LouXuezhi/FPGA_farseer_Code/report/llm_log/02_mipi_lane1_fault_location.md

# 02 MIPI lane1 无数据：从寄存器假设到定位单根断线

中文 | [English](02_mipi_lane1_fault_location_en.md)

会话：OV9281 → FZ3B 的 CSI-2 2-lane 接收，lane1 始终收不到完整一行　日期：2026-10-29～30

## 提示词（整理）
> 把整个相机链路跑起来，再尽量提高采集速率。
> （中途补充）OV9281 手册里 lane 数在 0x3039[7:5]，0x3018 不是 lane 数控制；dl1_stop 能变、hsact=0 还分不清 P/N 反接、信号完整性和 PHY 时序，别过早锁定硬件原因。
> （之后）转接板通断我们测了都没问题，也重新共地了，你再测一下。

## 模型回答（摘要）
- 自写 D-PHY + CSI-2 解析 + VDMA 比特流上板：lane0 头字节 `2B 06`（RAW10、WC=1600 高字节），线序和极性正确；lane1 每次都报 SoT 错误。
- 改写 component 模式 D-PHY（IBUFDS_DPHY + IDELAY + ISERDES），每条 lane 同时搜正反两种极性的同步码并扫 tap。lane0 在 tap 0～288 全部 100% 命中；lane1 最高 69%，ECC 几乎全错。
- lane1 命中率随速率下降反而变差（800 Mb/s 59%，256 Mb/s 3%），与普通时序余量问题的规律相反。
- 编一个专用探测比特流：6 根 MIPI 线改成 1.2 V 普通输入加内部下拉，统计高电平占比。只有 D1_N（J8-8）在待机、开流、复位三种状态下都是 0%，其余 5 根随相机状态变化。
- 给出万用表二极管档对比测法：同一对的 P 线（第 7 脚）当参照，分"只插排线"和"只插相机"两种接法测。

## 纠错
- 模型先按 mainline 驱动寄存器表，用 0x3018=0xD0 测"单 lane"，据此认为模组只能 2-lane。用户指出 lane 数在 0x3039[7:5]。模型确认之前的测试并没有切到单 lane，改写 0x3039=0x12 重测（读回生效，但 lane0 字节结构仍是 2-lane 拆分，结论记为"未定"）。
- 早期判断偏向"P/N 反接"，用户提醒保留多种假设。模型改用极性自搜索 PHY 和引脚探测去区分，而不是直接下结论。
- 用户第一次回报"测试 B 第 8 脚 OL"，第二次又说"16 根是 0"。模型没有直接采信，先追问读数是 0.000 还是 OL，并要求测第 2、15 根 GND 确认金手指编号方向没数反。用户复测后改口为"16 和 18 都约 0.5 V"。
- 换新 25P 排线后结果完全不变，模型据此排除排线，把范围缩到相机侧。

## 结果
- 三组测量合并：尾线拔下时金手指 16、18 对 GND 都约 0.5 V；插上后 FPC2-8 对 GND 为 OL；FPC2-8 ↔ FPC1-16 焊盘导通。
- 结论：断点在转接板 FPC1 座第 16 脚与金手指之间（座子引脚虚焊或触点未压实）。之前的通断测试点在焊盘上，没有经过座子引脚，所以没测出来。
- 修复前系统按 lane0 单独出图继续推进（见 03）。
