LouXuezhi/FPGA_farseer_Code/report/llm_log/03_framerate_sweep_false_positive.md

# 03 帧率扫描的假阳性：行数完整不等于画面有效

中文 | [English](03_framerate_sweep_false_positive_en.md)

会话：lane0 单独出图后提高采集帧率　日期：2026-10-30

## 提示词（整理）
> 把相机链路跑起来，然后尽量提高采集速率，看能不能把它完整利用起来。我回来验收。

## 模型回答（摘要）
- lane1 故障期间，先加 lane0-only 解析模式：lane0 带每行的偶数字节，按 RAW8 得到 640×800 半分辨率图像，把 VDMA → DDR 通路先跑通。
- 首帧：144.8 fps，每帧正好 800 行，坏包头 0。
- 写 `fpssweep.py` 扫 PLL 倍频和 VTS/HTS 组合，每组记录帧率、每帧行数、坏包头、FIFO 溢出和 VDMA 状态，最初的合格标准是"每帧 800 行且无错误"。
- 两组高帧率配置各连续跑 10 s 确认稳定，再各抽一帧目视检查。

## 纠错
- 第一轮扫描报出 229 fps 和 546 fps 两个"合格"点。模型抽帧检查时发现画面是空白或恒定值：HTS 低于 0x2d8 或 VTS 压得太低时，传感器仍按格式发 800 行，但内容已经没有了。
- 模型把"画面有内容"加进合格条件后重新扫描，并在验收报告里明确写出第一轮的数字是假结果、原因是什么。
- 同一会话里 Vivado 第一次构建被杀（退出码 137）：Docker 虚拟机只有约 7.75 GB 内存，8 个综合任务并行。模型没有改 Docker Desktop 全局设置，改成 `-jobs 2` 串行构建后通过。

## 结果
| 传感器模式 | 实际图像 | 最高合格帧率 | 写 DDR 数据量 |
|---|---|---|---|
| 1280×800 RAW8 | 640×800 | 149.8 fps | 约 77 MB/s |
| 640×400（2×2 binning） | 320×400 | 299 fps | 约 38 MB/s |

- 默认工作点定为 1280×800、VTS 910、144.8 fps（第一张真实图就是这个点，用户目视确认）。
- 合格标准：每帧行数完整、无坏包头、VDMA 无报错、画面有内容，每组连续 10 s。
- 后续实时网页流在 Mac 端 15 s 收到 2173 帧（144.8 fps），0 坏帧。
