LouXuezhi/FPGA_farseer_Code/report/llm_log/09_web_launcher_one_click.md

# 09 相机网页一键启动与连接栏：用模拟相机先测，再上真机

中文 | [English](09_web_launcher_one_click_en.md)

会话：把相机预览服务做成双击启动，网页加重连等按钮　日期：2026-10-30

## 提示词（整理）
> 帮我做成一个自动化脚本，点一下就能直接启动；再在网站上加按钮，比如重新连接之类的。

## 模型回答（摘要）
- 服务结构改为"没有相机也能启动"：网页显示原因并在后台不断重试，不再像以前那样直接启动失败。
- 新增接口：重新连接相机（硬复位、查芯片 ID、重新开流）、重载比特流、停流、重启服务，无相机时返回 503 占位图。
- 网页顶部加连接栏：绿/黄/红状态灯和原因文字（例如"I2C 不应答，检查尾线"），画面中断 2 s 或连接失败时自动重连。
- 桌面放一个 `.command` 启动器：找到连板子的 USB 网卡并设地址，等板子上线，对比 Mac 与板上代码，有改动才上传并重启服务。

## 纠错
- 部署到板子前，模型先在 Mac 上用模拟相机跑新服务，8 种测试情况全部通过；再在浏览器里模拟拔线、恢复、服务退出，检查页面状态与自动恢复。
- 测"重启服务"按钮时点击落在了 `confirm()` 对话框上，什么都没执行。模型改为直接杀掉服务进程来模拟重启，确认页面先变红，约 2 s 后视频和文件列表自动恢复。
- 模型把网卡改回自动获取地址，模拟"Mac 忘了 IP"的情况，结果启动脚本找不到网卡。原因是网络服务列表每行以 `(` 开头，而 sed 规则假设行首是 `Hardware Port:`。修正解析后，脚本能自己找到 AX88179B 并设回 192.168.1.253，Wi-Fi 和默认路由不受影响。

## 结果
| 按钮 | 实测 |
|---|---|
| 重新连接相机 | 不到 1 秒 |
| 重载比特流 | 约 1 秒 |
| 重启服务 | 约 1.5 秒后网页自动恢复 |
| 自动重连 | 模拟拔线后能自己恢复 |

- 重连或重启后曝光和增益保持不变，读传感器寄存器确认过；每次恢复后 144.8 fps、每帧 800 行、坏包头 0。
- 真实页面渲染连接栏，控制台无报错；用法写入 `README_live.md`。
