LouXuezhi/FPGA_farseer_Code/report/llm_log/10_overexposure_root_cause.md

# 10 夜间采集图像过曝：逐步排除，并承认判断不严谨

中文 | [English](10_overexposure_root_cause_en.md)

会话：自动采集运行中画面"发花"，排查原因　日期：2026-11-01

## 提示词（整理）
> 现在画面怎么有点花？（之后）先暂停采集，看从哪里开始过曝。温度不是挺正常吗，怎么还会过曝？分析一下是随时间逐步恶化，还是一到 50 °C 就变成这样。

## 模型回答（摘要）
- 先排除传输：帧率约 144 fps、坏包头 0、撕裂帧 0；平均亮度 254（之前约 106），削顶 98.8%，是过曝不是花屏。在用户确认前不改曝光，避免影响正在保存的数据。
- 暂停 AUTO、关闭加热、停掉定时补测后，扫描全部已存 RAW：22:29 均值约 114，01:30 约 156，02:50 约 190，03:42 约 244，04:12 以后超过 250。
- 2254 帧、129 个文件、约 13.8 h 的统计：同为 50 °C，00:58 均值约 139，04:54 约 252；后来目标回到 40 °C 也没恢复，否定"一到 50 °C 就全白"。
- 按用户方案每次只重启一部分：比特流重载 + 相机复位后仍 254.6/99.4%；整板断电后仍 254.6/99.3%；激光器重启后 249.4/92.2%；关闭激光后新鲜帧均值 18.8。

## 纠错
- 模型此前把网页上显示的"曝光 100 行、增益 6×"当成传感器实际状态，后来明确改口："之前我把相机状态里的参数当成实际曝光状态，这个判断不够严谨"；"数据证明的是亮度随时间恶化，还没有证明曝光寄存器失控"。
- 模型承认之前报告的"23/45 组完成"只检查了温控稳定和文件存在，没有检查图像质量，不能等同于 23 组可用。
- 关激光测试时发现 RAW 接口新连接会先发一张缓存帧，没有客户端时这张缓存不更新。模型指出之前"短连接只取第一帧"的采样和部分重启后的判断可能取到了旧画面，之后改为丢弃前 5 帧、连续取 81 帧再判断。
- 更早一轮板子卡死的排查里，模型先猜 VDMA 写的 0x70000000 未被内核预留；查设备树发现它在预留区 `buffer@0` 内，主动撤回这个猜测。

## 结果
- 定位：饱和与入射激光/光路有关，相机参数未变；用户观察到激光散射明显变大，与数据一致。
- 45 °C 后半段与 50 °C 的 RAW 判为不可用，后续补测前先修正曝光。
- 由此引出采集规范改动：按 session 锁曝光、记录亮度偏离事件（见 11）。
