LouXuezhi/FPGA_farseer_Code/report/llm_log/12_dataset_handoff_role_mixup.md

# 12 数据集交接脚本：理解错任务，以及坏点规则不可用

中文 | [English](12_dataset_handoff_role_mixup_en.md)

会话：按《数据集交接规范》写开发脚本并迭代　日期：2026-11-01

## 提示词（整理）
> 这是我们的数据集交接规范。在深入研究现状和意图的基础上写开发脚本，不断迭代。
> （之后）你的任务是什么？是写训练脚本吗？

## 模型回答（摘要）
- 写了 `fz3b_data.py`：建索引、`load_index`、`FrameStore`、`preprocess`、`make_pairs`，只依赖 numpy，扫数据盘约 13 s。
- 用真实数据核对：rerun 12 个 session / 464 帧、legacy 2254 帧，与规范一致；插值温度与最近读数最多差 0.18 °C；hold 段相隔 1 s 两帧预处理后相关 0.98（规范给的是 0.99）；预处理约 2 ms/帧。
- 离线端到端测试：假串口 + 假相机跑采集脚本，再用 `fz3b_data.py` 读回，过冲时停机并关闭加热，没有帧对跨越相机重启。

## 纠错
- 坏点规则：第一次建索引报出 1840 个坏点，模型判断"远远过多"，查出规范 v1 的规则下实测偏差为 0、规则不可用。改为"抽取相隔 ≥30 s 的帧，至少一半帧中偏离邻域 5σ 才算坏点"，得到 51 个，写进规范 v1.1。
- 间隔检查误报：20 s 采样切到 1 s 采样时，10 帧 hold 段被误判为 `cam_gap`，修正后 464 帧全部有效。
- 与另一会话冲突：模型发现 `ramp_collect.py` 被另一会话的 199 行实现覆盖，先确认对方在改，再协商分工（对方管采集脚本，本会话管 `fz3b_data.py`）。对方指出模型写的安全检查在降温台阶（如 42→39）会立刻误停，模型承认并弃用自己的版本。
- 用户问"你的任务是什么"。模型直接承认："不是。我理解错了任务，按数据侧去写了"。规范开头写的是"给训练脚本设计方"，训练侧负责模型、损失、训练循环和评估，这部分还没开始。已写的 `fz3b_data.py` 是训练脚本要读的那一层，可以保留。

## 结果
- 索引建在数据盘 `FZ3B_dataset/index`：2718 帧，其中 464 帧可用，可组成 294 个帧对。
- 新增规则：温度断流后的帧全部标为不可用（假断流测试正好标出之后 16 帧）；仍在录制的 session 建索引时跳过。
- 规范升到 v1.1，并补充：温度传感器分辨率 0.0625 °C，所以"<0.05 °C"一档实际意思是"读数没变"。
