LouXuezhi/FPGA_farseer_Code/report/llm_log/14_laser_drift_study.md

# 14 激光慢漂移专题：去漂移方法全部无效，转为时间平均变化检测

中文 | [English](14_laser_drift_study_en.md)

会话：不动硬件的前提下应对激光器慢漂移　日期：2026-11-03

## 提示词（整理）
> 开一个专题，研究不动硬件的情况下怎么应对激光器带来的慢漂移。
> （之后）部署是不是用滑动窗口？激光是 450 nm，能不能做敏感性消融，需要重新训练吗？
> （之后）现在是报警吗？不是绝对温度检测？

## 模型回答（摘要）
- 漂移维数高：20 个主成分才解释 80% 方差；状态不复现，隔几小时最像的一帧相关也只有 0.08。
- 试过且无效：PCA 学漂移子空间再扣除（另一 session 漂移能量只降 2～3%）、session 开头基线学子空间、亮度回归图案、按亮度挑参考帧、分块局部检出。
- 有效做法：60 s 平均图案，与相隔 120 s 的平均图案比 1−corr，阈值取不加热对照的 99% 分位。
- 消融不需要重新训练，检测器没有可训练参数，每组参数只重算一次门限，全部约 4 分钟跑完。
- 对绝对温度问题直接给否定回答：同一路两次升到同一温度，两次稳态图案相关 −0.01，图案和温度无法一一对应。

## 纠错
- 部署模拟（每 10 s 评估、连续 3 次超限报警、冷却 300 s）显示 01:33 的对照出了 3 次误报。模型没有调门限去掩盖，而是指出这是当晚第一个 session，可能是激光预热不足，并说明这只是推测，需要再录一次刚开机的对照确认。
- 回放时发现报警间隔几乎正好 305 s。模型据此检查稳态段，发现加热但探头读数已稳定时，仍有 30～58% 的窗口超过门限（不加热时只有 0.5%）。模型修正了对检测器含义的描述："它回答的是现在有没有局部加热，不是探头读数在不在变"，并提醒答辩时不要说成"只在升温瞬间报警"。
- 用户提出用长短窗口或多头 CNN 输出具体度数。模型用数据检验后给出反对意见：把速率累加成总温升，估计值比实际大 3～4 倍、秩相关 0.33，不建议改网络结构重新综合。

## 结果
| 升温幅度（单路 2 分钟内） | 检出率 |
|---|---|
| ≥ 2 °C | 100% |
| 1～2 °C | 93% |
| 0.5～1 °C | 66% |

- 去相关与温度变化的秩相关从逐帧比较的 0.16～0.28 提高到 0.69～0.79。
- 升温台阶（≥ 2 °C）36 个全部检出，延迟中位 111 s。
- 速率三档（无/慢/快）在拟合时未录完的 session 上判对 82%，"无"与"快"互判 0。
- 报告口径改为"分钟级局部温升检测与报警"，跨小时绝对温度写作需要稳频光源的后续工作。
