LouXuezhi/FPGA_farseer_Code/report/llm_log/15_eval_leakage.md

# 15 报警评估指标虚高

中文 | [English](15_eval_leakage_en.md)

会话：窗口融合报警方法的留出评估　日期：2026-11-03

## 提示词（整理）

> 窗口融合报警在 5 折评估里检出率很高。数据是第三次采集的 11 段（4 段纯对照、5 段长平台、2 段游走/台阶）。
> 请检查训练和测试的划分、门限和标准化参数是否用到了测试数据，有问题就给出只用训练折的方案。

## 模型回答（摘要）

- 训练集里混入了不加热的对照段，测试折的对照段与训练折里的对照段来自相邻时间，漂移状态相近，门限因此偏松地"恰好合适"。
- 标准化用的均值、标准差和门限也是用全部对照段算的，测试数据参与了参数确定。
- 方案：每折留出 1 段长平台 + 1 段对照；均值、标准差、门限只用训练折的对照段确定；融合权重固定（1 : 0.1）不在测试折上调。

## 纠错

这一问题由助手在复查自己写的评估脚本时主动指出，随后按新划分重算全部指标。

## 结果

嵌套留出（`src/model/win_alarm/nested.py`）下：≥1 °C/2 min 检出 92%（1% 误报），30/30 次升温事件报警，延迟中位 25 s；
4 段对照共 1.5 h 误报 4 次。数字见 `src/model/win_alarm/README.md` 和设计报告第三部分。
