LouXuezhi/FPGA_farseer_Code/report/llm_log/17_report_v3_no_overclaim.md

# 17 报告第三版：只写数据站得住的结论

中文 | [English](17_report_v3_no_overclaim_en.md)

会话：按 AMD 参赛要求和模板完善作品报告　日期：2026-11-03～04

## 提示词（整理）
> 按 AMD 参赛要求和 ref 里的模板继续完善报告，语言简洁，不用生造词；给答辩前的改进留余地；图用 2～3 个色系。
> （之后）现在用 CNN + 滑动窗口，报告只讲报警，不讲逐路绝对温度；把 CNN + 滑动窗口作为本设计的方法，和其他方法对比，图文并茂写正文。

## 模型回答（摘要）
- 对照模板与 AMD 3.3.5.3 列出现稿缺的五项：软硬件划分依据、优化前后对比表、大模型协作记录、技能包提炼过程、复现说明。
- 指出现稿数字过时：LUT 22.4%、DSP 30.8%、WNS +3.98 ns，提交目录布线后报告为 LUT 28.7%、DSP 30.0%、WNS +3.039 ns，以后者为准。
- 方法：60 s 窗口平均图案对送入 QCNN，与 1−corr 融合，连续 3 次超限报警、冷却 300 s。5 折，每折留出 1 段长平台和 1 段对照，门限只用训练折的对照来定。
- 用户问 FPGA 为什么比 PC CPU 慢，模型解释：网络只有几 MMAC，CPU 4～5 GHz 加向量指令 0.22 ms 算完；推理核 100 MHz、104 个 DSP，层间流水提高吞吐而不缩短单帧延迟，板上 1.33 ms 还含 Python 调 DMA 的开销。

## 纠错
无明显纠错。这段的价值在于模型按对比数据限定了结论的写法：
| 方法 | AUC ≥1 °C | 检出（1% 误报） | 事件检出 | 延迟中位 |
|---|---|---|---|---|
| 本设计 | 0.993 | 92% | 30/30 | 25 s |
| ResNet-18 微调 | 0.994 | 95% | 30/30 | 62.5 s |
| MobileNetV3-S 微调 | 0.992 | 94% | 30/30 | 32.5 s |

- 模型写明"检出率和微调 ResNet-18 持平，没有超过它，报告里不写精度第一，评委用原始数据一查就会露馅"。能站住的是：延迟短一半、计算量约为其 1/270、只有本设计能在 PL 上实时跑。
- 对照数据 1.5 h 误报 4 次，全部来自同一段对照，报告如实写出。
- 上板后发现融合得分在不加热时也越过门限。模型查到相机曝光被停在 1（亮度 19），恢复自动曝光后仍偶有误报，判断为光路状态与标定时不同：板上录了 21.5 min 不加热数据，块相关中位数 0.43，标定时为 0.23。模型没有直接调高门限，而是建议按 `src/model/win_alarm/README.md` 的步骤用新录的对照数据重新标定。

## 结果
- 报告 v3 共 24 页，按藏青、青绿、橙三个色系新画 10 幅图。
- 训练权重导出到 RTL，仿真 144/144 逐位一致；重建比特流 100 MHz 域 WNS +2.55 ns，LUT 28.8%。
- 上板后 PL 推理 40/40 逐位一致，单帧 1.34 ms；留给答辩前的改进写在第四部分（预处理 2 s → 41 ms 未接入、时钟余量、更多对照数据）。
