LouXuezhi/FPGA_farseer_Code/build/ui_panel/panel_a.png

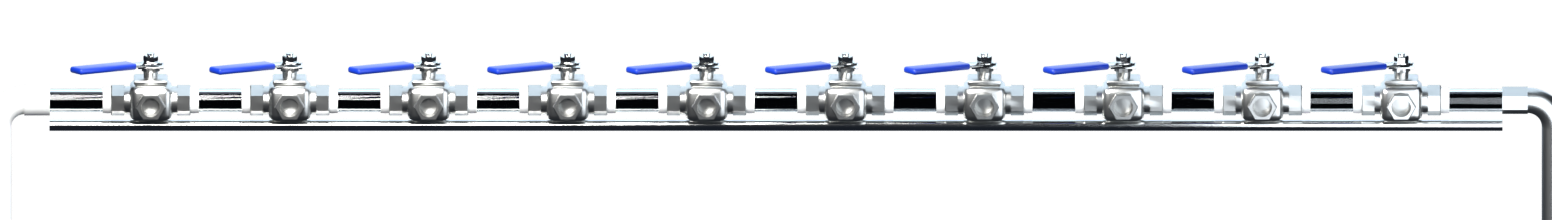
build/ui_panel/panel_a.png
