LouXuezhi/FPGA_farseer_Code/report/llm_log/16_compare_experiments_honest_claims.md

# 16 对比实验：逐项标注优势成立与不成立

中文 | [English](16_compare_experiments_honest_claims_en.md)

会话：与现成模型、其他部署方式对比，展示算法与软硬件协同优势　日期：2026-11-03

## 提示词（整理）
> 在我们的数据上跑一些现成模型，说明我们模型的优越性。展示两方面：算法优越性；软硬件协同优越性，着重 FPGA。做实验画图。
> （之后）列个表，看看我们的模型有没有这两方面优越性。现成的模型能做到比较好的温度检测吗？不是单纯超温预警。

## 模型回答（摘要）
- 板上实测：PL 输出与定点参考逐位一致 65/65；单帧（含 DMA）1.33 ms，批 16 为 0.64 ms/帧。
- 同一 QCNN 在 A53 上：ONNX Runtime fp32 2.44 ms，NumPy 定点 33.5 ms；A53 上的现成模型 96～2668 ms。
- 自采数据温升检测：1−corr 方法 AUC 0.998，1% 误报下 ≥1 °C 检出 97%；逐帧 ZNCC 33%，ResNet-18 特征 18%，ViT 特征 11%，有监督岭回归 24%。
- 对现成模型测温能力：开机校准一次、4 折留出，加热点 MAE 不测（恒 0）9.6 °C，ResNet-18 微调 8.5 °C，MobileNetV3-S 微调 8.4 °C，QCNN 结构 9.0 °C，都只比"不测"好约 1 °C。

## 纠错
无明显代码纠错。这段的价值在于模型没有顺着"展示优越性"的要求写结论，而是把不利结果放在表里：
- 同一 QCNN 在 PC CPU / RTX 4060 Ti 上只要 0.22 / 0.26 ms，比 PL 快，所以对台式机只比能耗（PL 0.29 mJ，GPU 跑 MNet-reg 48 mJ），并标明两边口径不同。
- 整机每帧 2.02 s，瓶颈在 PS 预处理（2014 ms），PL 加速在整机上没有体现。模型写了 OpenCV 版预处理（41 ms，与原版相关 0.99997），但注明"还没接进节点，只是估算"。
- 重复同一帧时 PL 测到 0.66 ms，比仿真首帧延迟还短，原因不明，模型选择不使用这个数。

## 结果
- 对比图与数字收进设计报告第三部分（表 3-2、图 3-10、图 3-11）。
- 报告口径：精度相近（差 0.4 °C 以内）下计算量为现成模型的 1/20～1/7000；与板上 A53 可部署模型相比快 70～2000 倍；与 GPU 相比单次能耗低一个数量级以上。
- 用户据此决定：报告只写自采数据上的对比，软硬件协同只留站得住的指标（板上延迟、能耗、与 A53 对比）。
