LouXuezhi/FPGA_farseer_Code/(commit log)

2026-09-18 Add .gitignore
    Datasets, third-party repos, checkpoints and tool-generated files stay out;
    only board/<board>/prebuilt/ bitstreams are shared.
2026-11-03 fiber_speckle_thermo: 预正式版工程包（PL QCNN 推理 + 窗口融合报警）
    按 AMD 选题指南 3.3.5.4 目录结构：src/ sim/ build/ board/ data/ skill/ report/。
    推理核载入训练权重 data/fusion/qmodel_win.npz；附预编译比特流、综合实现报告、
    仿真日志、设计报告与系统架构说明（report/architecture.md）。
2026-11-03 skill: 补齐校验脚本与提示词工作流；report: 加入大模型协作记录摘录
    - skill/scripts/hwh_map.py：无 PYNQ 时从 .hwh 读地址表与 IP 参数（标准库）
    - skill/scripts/check_vivado_reports.py：布线后报告提取指标并按门限判定
    - skill/scripts/compare_golden.py：硬件输出与参考模型逐位比对
    - skill/prompts/README.md：四个提示词模板
    - report/llm_log/：三段交互摘录
2026-11-04 README 中英双语并加成果对比表；skill 跨器件自测；llm_log 扩充到 17 段
    - README：报警效果与 6 种方法同协议对比、板上推理对比、推理核优化对比
    - skill：hwh_map / check_vivado_reports 在 Zynq-7000 xc7z020（Vivado 2017.4/2025.1/2026.1）
    样例上自测，skill/tests/run_tests.sh 15 项
    - report/llm_log：覆盖采集链、RTL、驱动、显示、数据、算法探索、评估、报告
2026-11-04 中英文文档分开；去掉 DEMO 权重标记
    - README、skill、skill/prompts、report/architecture、report/llm_log：中文与英文各一份，互相跳转
    - 去掉节点 --demo 参数和屏幕/上位机上的 DEMO 权重标记；硬件连接图里的屏幕缩略图同步去掉该标记
    - 屏幕合成仿真重跑：384000/384000 像素一致；test_node、test_ui_filter、skill 自测全部通过
2026-11-04 文档加入结果与分析图；报告与结构图更新到 11-04 09:19 版
    - README（中/英）：散斑原理、恒温漂移、方法对比、报警过程、检出率与延迟、
    两路得分分布、板上推理、PL 方案对比、测温台、数据集时间线、散斑视图
    - architecture、win_alarm、build、src/host README 补相关图
    - build/README 实现结果更新为训练权重比特流（WNS +2.545 ns，LUT 28.8%）
    - 设计报告换为 09:19 版，硬件连接图中的旧测试权重标记已去掉
